ashmatov/one/CHANGES.txt

2023.11.01 - Initial release of version 1.0
2023.11.02 - Release of version 1.1. Changes: power switch silkscreen fix, diodes footprint fix, logo addition
2025.11.17 - Release of version 1.3. Changes: controller position updated and model lineup expanded: Standard, Short (S), Aggressive (A), and Aggressive Short (AS). 
  * PCB by [Igor](https://github.com/igor-salt)
  * Case by [Roman](https://github.com/belinski-roman)
