ashmatov/one/pcb/normal/keys_place.ods

 | Classic version |  | A version |  | Offset
 | X | Y | X | Y | X | Y
SW1 | 84.5 | 66.99097 | 84.5 | 76.09097 | 0 | -9.09999999999999 | f
SW2 | 103.5 | 66.99097 | 103.5 | 76.09097 | 0 | -9.09999999999999 | f
SW3 | 122.5 | 62.24097 | 122.5 | 63.94097 | 0 | -1.7 | f
SW4 | 141.5 | 59.86597 | 141.5 | 57.86597 | 0 | 2 | f
SW5 | 160.5 | 62.24097 | 160.5 | 63.24097 | 0 | -1 | f
SW6 | 179.5 | 64.61597 | 179.5 | 64.61597 | 0 | 0 | b
SW7 | 84.5 | 85.99097 | 84.5 | 95.09097 | 0 | -9.09999999999999 | f
SW8 | 103.5 | 85.99097 | 103.5 | 95.09097 | 0 | -9.09999999999999 | f
SW9 | 122.5 | 81.24097 | 122.5 | 82.94097 | 0 | -1.69999999999999 | f
SW10 | 141.5 | 78.86597 | 141.5 | 76.86597 | 0 | 2 | f
SW11 | 160.5 | 81.24097 | 160.5 | 82.24097 | 0 | -1 | f
SW12 | 179.5 | 83.61597 | 179.5 | 83.61597 | 0 | 0 | b
SW13 | 84.5 | 104.99097 | 84.5 | 114.09097 | 0 | -9.09999999999999 | f
SW14 | 103.5 | 104.99097 | 103.5 | 114.09097 | 0 | -9.09999999999999 | f
SW15 | 122.5 | 100.24097 | 122.5 | 101.94097 | 0 | -1.69999999999999 | f
SW16 | 141.5 | 97.86597 | 141.5 | 95.86597 | 0 | 2 | f
SW17 | 160.5 | 100.24097 | 160.5 | 101.24097 | 0 | -1 | f
SW18 | 179.5 | 102.61597 | 179.5 | 102.61597 | 0 | 0 | b
SW19 | 151 | 119.7407 | 151.5 | 119.7407 | -0.5 | 0 | b
SW20 | 172.135076 | 122.523186 | 172.135076 | 122.523186 | 0 | 0 | b
SW21 | 192.153537 | 130.867912 | 191.477264 | 130.419173 | 0.676273000000009 | 0.448738999999989 | b
SW20 | turn | -15 |  | -15 |  | 0
SW21 | turn | -30 |  | -30 |  | 0
