ashmatov/one/cases/3d/modern/aggressive short/bottom.step

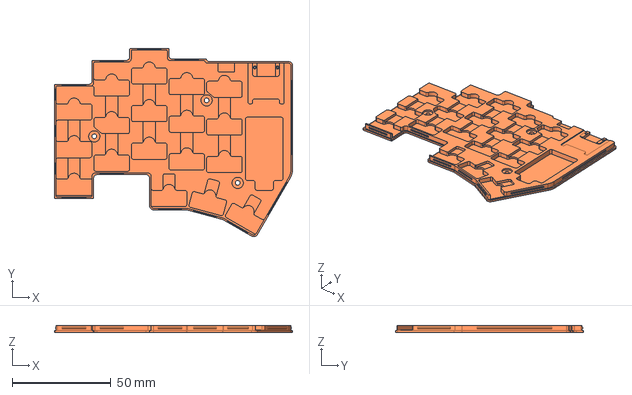
[picture p1: CAD file, 2025-11-17]
cases/3d/modern/aggressive short/bottom.step
120.3 x 95.2 x 3.70 mm
