ashmatov/one/cases/3d/modern/aggressive/bottom.step

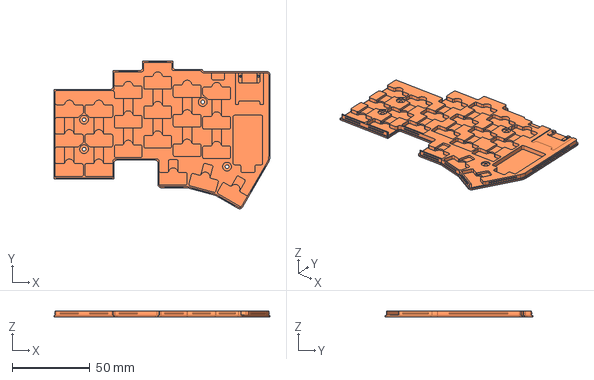
[picture p2: CAD file, 2025-11-17]
cases/3d/modern/aggressive/bottom.step
139.3 x 95.2 x 3.70 mm
