ashmatov/one/cases/3d/modern/normal/bottom.step

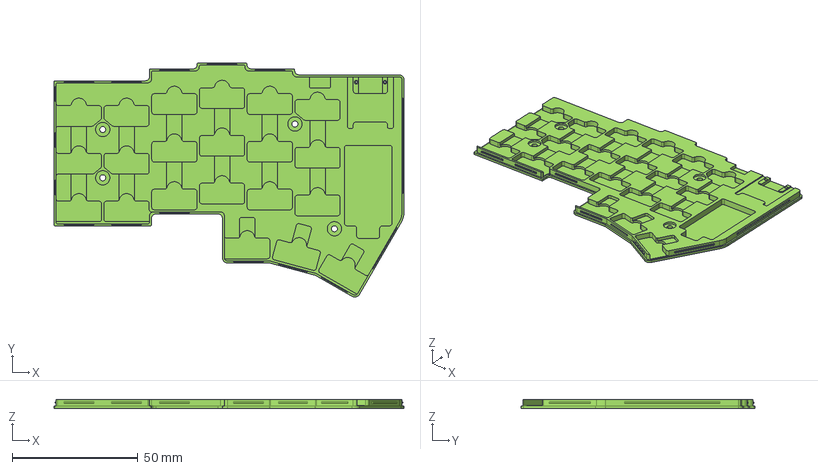
[picture p3: CAD file, 2025-11-17]
cases/3d/modern/normal/bottom.step
139.3 x 93.2 x 3.70 mm
