ashmatov/one/cases/3d/modern/short/bottom.step

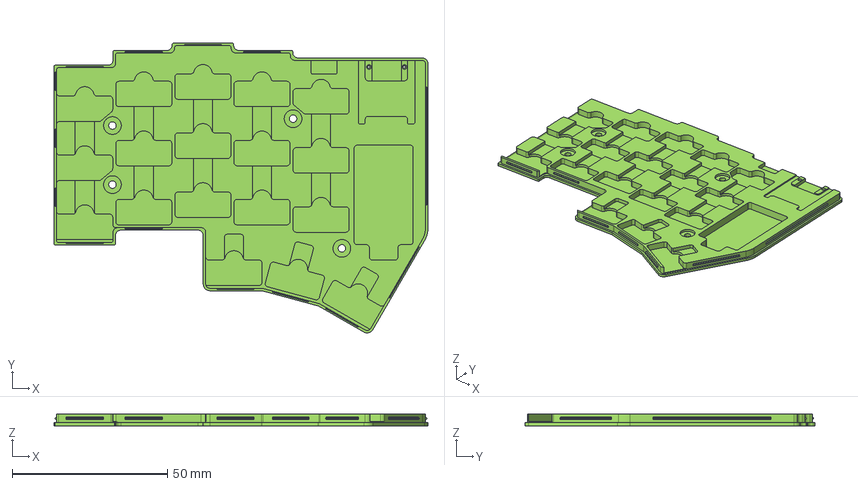
[picture p4: CAD file, 2025-11-17]
cases/3d/modern/short/bottom.step
120.3 x 93.2 x 3.70 mm
