ashmatov/one/pcb/normal/1_3.kicad_pcb

## KiCad design pcb/normal/1_3.kicad_pcb (2025-11-17)

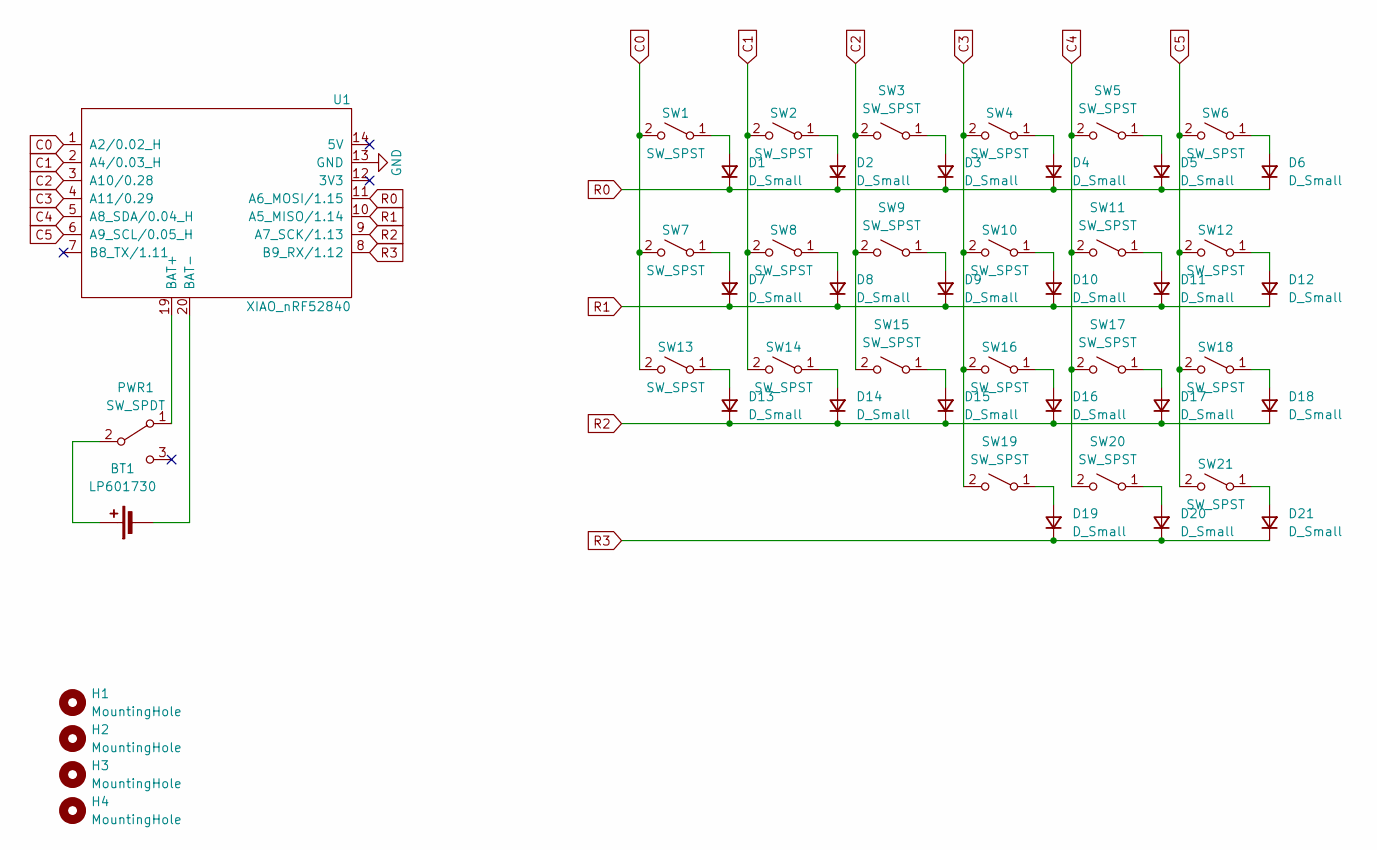
[picture p5: schematic 1_3.kicad_sch]

Parts:
BT1: LP601730; lp601730
D1, D2, D3, D4, D5, D6, D7, D8, D9, D10, D11, D12, D13, D14, D15, D16, D17, D18, D19, D20, D21: D_Small; Diode_TH_SMD_DUAL
H1, H2, H3, H4: MountingHole; Hole_5.7mm
PWR1: SW_SPDT; MSK-12C02_DUAL
SW1, SW2, SW3, SW4, SW5, SW6, SW7, SW8, SW9, SW10, SW11, SW12, SW13, SW14, SW15, SW16, SW17, SW18, SW19, SW20, SW21: SW_SPST; KS-27_KS-33_Hotswap_1U_DUAL
U1: XIAO_nRF52840; XIAO_nRF52840_DUAL_WINDOW_NO_CAP

Connections:
C0: SW1.2 (B), SW7.2 (B), SW13.2 (B), U1.1 (A2/0.02_H)
C1: SW2.2 (B), SW8.2 (B), SW14.2 (B), U1.2 (A4/0.03_H)
C2: SW3.2 (B), SW9.2 (B), SW15.2 (B), U1.3 (A10/0.28)
C3: SW4.2 (B), SW10.2 (B), SW16.2 (B), SW19.2 (B), U1.4 (A11/0.29)
C4: SW5.2 (B), SW11.2 (B), SW17.2 (B), SW20.2 (B), U1.5 (A8_SDA/0.04_H)
C5: SW6.2 (B), SW12.2 (B), SW18.2 (B), SW21.2 (B), U1.6 (A9_SCL/0.05_H)
GND: U1.13 (GND)
unnamed: BT1.1 (+), PWR1.2 (B)
unnamed: BT1.2 (-), U1.20 (BAT-)
unnamed: D1.2 (A), SW1.1 (A)
unnamed: D2.2 (A), SW2.1 (A)
unnamed: D3.2 (A), SW3.1 (A)
unnamed: D4.2 (A), SW4.1 (A)
unnamed: D5.2 (A), SW5.1 (A)
unnamed: D6.2 (A), SW6.1 (A)
unnamed: D7.2 (A), SW7.1 (A)
unnamed: D8.2 (A), SW8.1 (A)
unnamed: D9.2 (A), SW9.1 (A)
unnamed: D10.2 (A), SW10.1 (A)
unnamed: D11.2 (A), SW11.1 (A)
unnamed: D12.2 (A), SW12.1 (A)
unnamed: D13.2 (A), SW13.1 (A)
unnamed: D14.2 (A), SW14.1 (A)
unnamed: D15.2 (A), SW15.1 (A)
unnamed: D16.2 (A), SW16.1 (A)
unnamed: D17.2 (A), SW17.1 (A)
unnamed: D18.2 (A), SW18.1 (A)
unnamed: D19.2 (A), SW19.1 (A)
unnamed: D20.2 (A), SW20.1 (A)
unnamed: D21.2 (A), SW21.1 (A)
unnamed: PWR1.1 (A), U1.19 (BAT+)
R0: D1.1 (K), D2.1 (K), D3.1 (K), D4.1 (K), D5.1 (K), D6.1 (K), U1.11 (A6_MOSI/1.15)
R1: D7.1 (K), D8.1 (K), D9.1 (K), D10.1 (K), D11.1 (K), D12.1 (K), U1.10 (A5_MISO/1.14)
R2: D13.1 (K), D14.1 (K), D15.1 (K), D16.1 (K), D17.1 (K), D18.1 (K), U1.9 (A7_SCK/1.13)
R3: D19.1 (K), D20.1 (K), D21.1 (K), U1.8 (B9_RX/1.12)

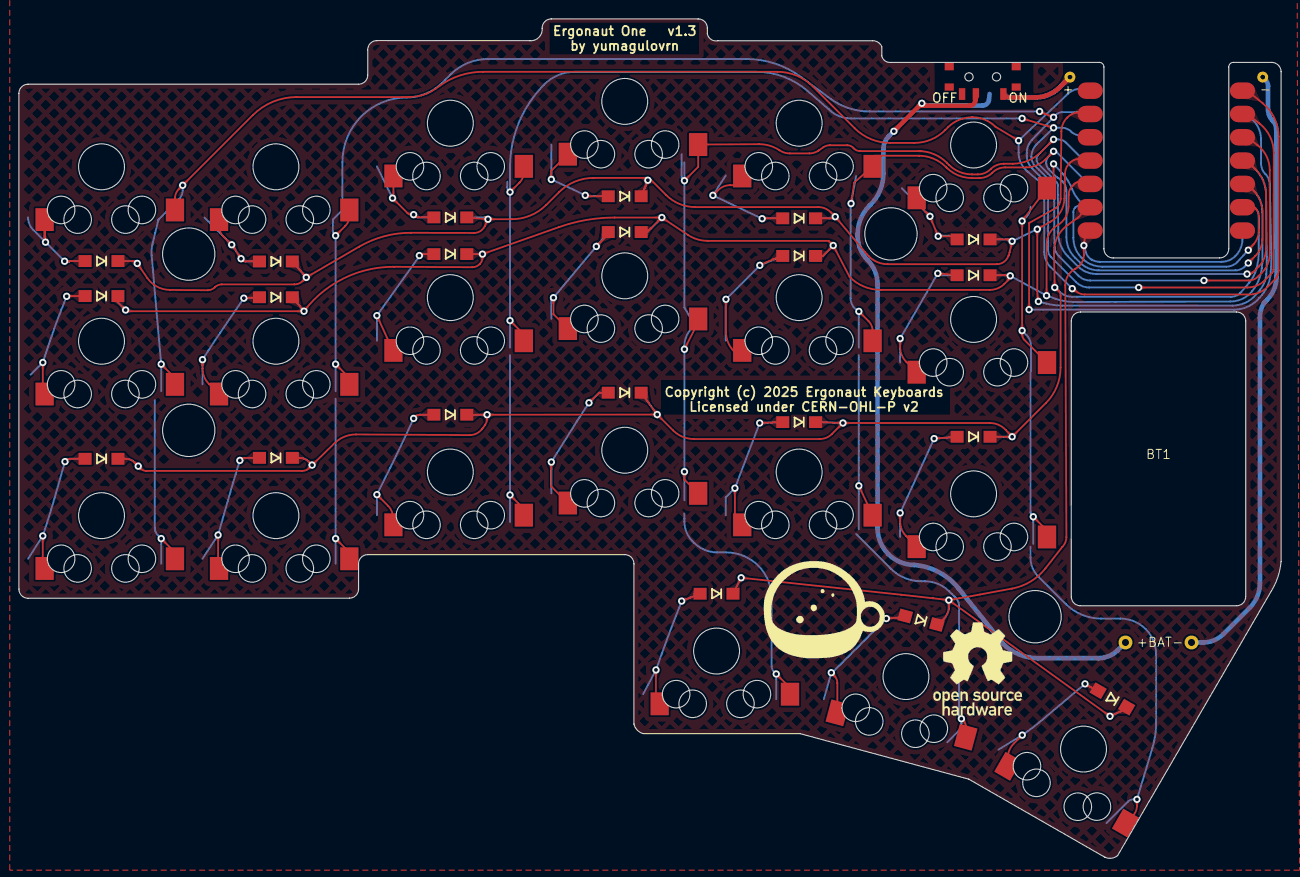
[picture p6: board 1_3.kicad_pcb from above]

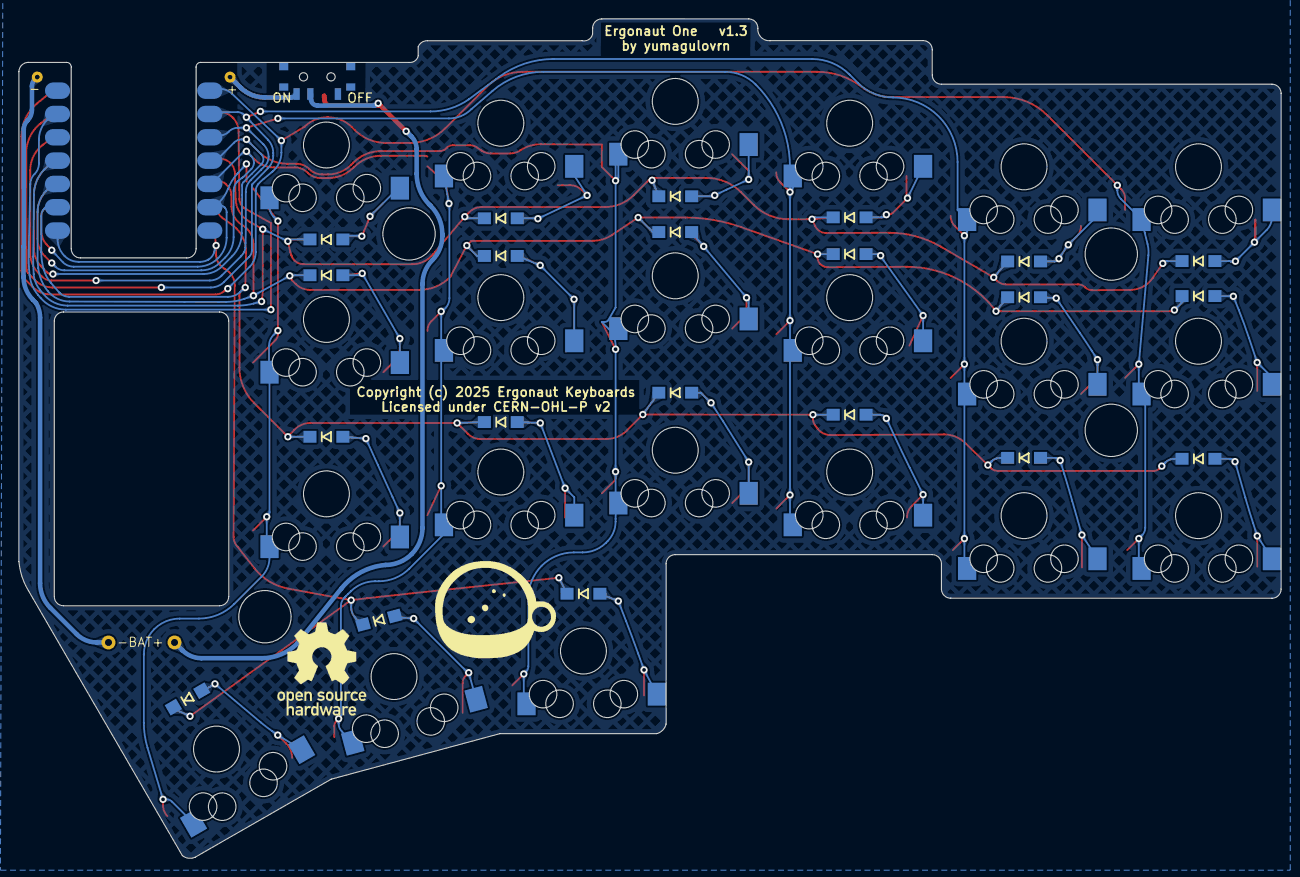
[picture p7: board 1_3.kicad_pcb from below]

Board: 2 copper layers, 137.5 x 91.4 mm, 49 parts (23 on the bottom side), 34 nets.
