ashmatov/one/(commit log)

2024-07-21 Move the power switch to the side, change the hole for the switch to 5mm, move the little finger group down, cut a hole to access the controller power pins, enlarge the mounting hole to 5.5mm
    [pcb.kicad_pcb, pcb.kicad_sch]
2024-07-29 Fix the power switch route
    [pcb.kicad_pcb]
2025-11-17 add v1.3
    [1_3-B_Cu.gbl, 1_3-B_Mask.gbs, 1_3-B_Paste.gbp, 1_3-B_Silkscreen.gbo, 1_3-Edge_Cuts.gm1, 1_3-F_Cu.gtl, 1_3-F_Mask.gts, 1_3-F_Paste.gtp]
