ashmatov/one/(notices)

Notices in the files:
pcb/aggressive short/1_3AS.kicad_pcb:
Copyright (c) 2025 Ergonaut Keyboards
Licensed under CERN-OHL-P v2
pcb/pcb.kicad_pcb:
Copyright (c) 2023 Ergonaut Keyboards
